whywhywhyt/fpga-sram-demo/engineering/README.md

# 工程快照

展示入口位于包根目录01_download_sram.cmd，使用固定已验证SVF，无TD依赖。
这里保留源码/IP、约束、仿真和最终证据。reports中的原电脑绝对路径与sram_downloaded字段是历史构建/下载记录，不代表接收电脑的状态。
省略可再生中间数据库与仿真work；改源码需从综合重建，不使用旧Resume。
