whywhywhyt/fpga-sram-demo/01_全部功能与按键.md

# 当前全功能与按键

本文件适用于 `sc520_cal_final_2026-11-01`。普通短按小于半秒，松手后执行；不要套用10月31日旧包的长K1开灯操作。

## 图像与处理

摄像头实时采集，DDR缓存，HDMI 1280×720显示。八模式依次是：彩色原图、灰度、二值化、Prewitt边缘、图像增强、颜色形状识别、运动检测、卡通化。启动默认边缘模式，短K2随时回原图。

图像处理含自动白平衡、按键触发白场标定与空间色彩补偿、显示中间调提亮、温和降噪及三档增强。白场校色不是全自动寻找白纸：需先摆好均匀白纸再按键。降噪和提亮不代表噪点、偏色已经完全消除。

颜色识别支持红、黄、绿、蓝；形状支持圆、三角、矩形，含未知分类，正方形归矩形。目标框按颜色显示，框附近显示颜色、形状和中心坐标，最多显示4个目标。建议实体红块移动展示坐标，电脑大色块和实心几何图案静态展示类别。传统颜色分割、连通域和几何特征，没有使用CNN或YOLO。

运动检测显示主要变化区域框及运动量。运动量不是实际物理速度；处理延时也不是摄像头到人眼的完整延迟。卡通化显示颜色分层与边缘描线。

## 按键总表

|操作|功能|
|---|---|
|短K1|原图→灰度→二值→边缘→增强→识别→运动→卡通→原图|
|短K2或单独长K2|回彩色原图，不关闭校色|
|K1+K2同时约2秒，全部松开|采白校色，成功后持续应用；按久不清表|
|单独长K3约2秒，任意图像模式|灯墙开/关；重新开启回流光|
|二值/边缘/识别/卡通，短K3/K4|对应阈值增加/减少；运动模式无此短按调参|
|增强，短K3/K4|增强低/中/高升档/降档|
|原图且灯墙开，短K4|流光→绘画→定格→彩虹涟漪→流光|
|流光/定格/涟漪，短K3|采背景，并返回流光|
|绘画，短K3|落笔/抬笔|
|绘画，长K4约1秒|换笔色并抬笔；之后短K3落笔|
|绘画，K3+K4同时约1秒|清屏并抬笔；之后短K3落笔|

## 校色

采白前固定摄像头和光照，白纸覆盖整个视场，避开手影、彩色边缘、反光和过曝；K1+K2约2秒全部松开，保持约1秒等待ON。采集中/计算中不是完成；FAIL表示此次采样不满足条件，调整白场后重采。失败重采保留已有有效系数，但失败提示仍需处理。

本版不提供CAL OFF，也不假装启动就有校色系数。断电/复位/重新下载后需要重新采白。采白自动算系数，无需逐色手动调RGB，同一光照下切换模式不用重新校色。

视频可说：“左下角ON表示白场校色已启用，用于减轻画面不同位置的偏色，让颜色更自然、均匀。”

## 灯墙四状态

双16×16灯板组成横向32×16。灯墙默认关闭，软件关灯会发送黑帧，外部5V仍存在。先K2回原图，长K3打开，固定机位、清空互动区，短K3采背景。

- 流光：空场全黑；物体进入对应区域有青色轮廓，移动留彩色拖尾，停住当前位置保持，离开渐隐。颜色由程序生成，不要求物体本身是青色。
- 绘画：用红色小卡片/笔帽作定位物，在HDMI画布区域内移动。先看定位十字，再短K3落笔，慢画横线、弧线或波浪；抬笔可移动而不连线。笔色青→蓝→紫→红→橙→绿，与红色定位物的颜色分开。
- 定格：保持画布，适合作品特写。
- 彩虹涟漪：前景互动，红色起点和彩虹色带扩散渐隐；保留已认可的原彩虹方案。

绘画取景区域为摄像画面约x320～959、y200～519，映射32×16；红色目标建议约4～6厘米、哑光、背景无其它红物。分辨率适合粗轮廓与简单符号，不适合精细字迹。遮挡和照明变化也可能被背景比较当作前景，不是专用手分类。

摄像头机位或照明变化后应重采灯墙背景。白纸校色与空场采背景需依次进行，不要拿白纸当灯墙空背景。
