whywhywhyt/fpga-sram-demo/02_全功能拍摄流程.md

# 全功能拍摄流程与按键

拍摄采用SRAM临时下载，不写Flash。本文以八图像模式、双灯板、K3长按开关的完整工程为准。
2026-11-01 16:37:48，`sc520_cal_final_2026-11-01`已下载到SRAM并通过DONE校验，未写Flash。本文按键均针对本次下载版本；仍需现场采白并检查实际画面。

## 开拍前完成

1. 保持开发板、USB、摄像头、HDMI、双灯板与5V电源的现有接线。下载后保持开发板供电，拍摄中不要重置或重新下载。
2. 固定摄像头位置、焦距和房间照明。准备白纸、实体红块、红色笔帽或红色小色卡，以及电脑上的四色/形状页面。
3. SRAM下载通过后等待约10秒，短按K2回彩色原图，检查实时画面、字幕、K1切换。
4. 用均匀照明的白纸覆盖整幅画面，K1+K2同时按约2秒后全部松开，再保持白场1秒，确认校色ON。移开白纸后继续使用同一照明。
5. K2回原图，长K3约2秒开启灯墙；固定摄像头，清空互动区域，短K3采背景，等待约2秒。测试双板左右连续。
6. 流光、绘画、定格、涟漪各试一次。准备拍图像模式时可长K3关闭灯墙；需要灯墙演示再长K3开启，回流光。

采白自动计算系数，无需手调RGB或为每种颜色重复校色。断电/重下载后需重新采白；摄像头位置或场景照明改变后需重新采灯墙背景。

## 建议拍摄顺序

| 顺序 | 展示项目 | 操作 | 拍到的现象 |
|---|---|---|---|
| 1 | 系统整体与实时原图 | 先拍摄像头、开发板、HDMI和双灯板，短K2；移动实体红块 | 实物动作与显示器实时画面对应，中文字幕清楚 |
| 2 | 灰度图像 | 从原图短K1一次 | 同一物体转为灰度，保留明暗层次 |
| 3 | 二值化和阈值 | 再短K1，短K3/K4分别加减阈值 | 黑白区域随阈值变化，参数提示可见 |
| 4 | 边缘检测和阈值 | 再短K1，用包装盒、纸片或手；短K3/K4 | 边缘轮廓及阈值调节的变化 |
| 5 | 图像增强低/中/高 | 再短K1，短K3提高、短K4降低档位 | 同一场景三档对比，强度字幕对应 |
| 6 | 颜色形状识别 | 再短K1，先移动实体红块，再展示电脑上的红黄绿蓝及圆形/三角形/矩形 | 框颜色与目标对应，上方颜色、形状及坐标；移动红块展示坐标连续变化 |
| 7 | 运动检测 | 再短K1，固定相机，单个物体缓慢左右移动后停住 | 主要变化区域框和运动量变化 |
| 8 | 卡通化 | 再短K1，拍色块、脸部或包装盒；短K3/K4可调边缘阈值 | 颜色分层、描边；再短K1回原图比较 |
| 9 | 灯墙开关和流光 | K2原图，长K3打开；清空区域短K3采背景后伸手 | 空场全黑，物体进入点亮、移动留拖尾、停住保留、离开渐隐 |
| 10 | 隔空绘画与换色 | 流光短K4到绘画；红色笔尖被识别后短K3落笔，慢速画横线/波浪；短K3抬笔移动 | 笔迹保留；抬笔移动不连线 |
| 11 | 多色绘画 | 绘画长K4约1秒换色，再短K3落笔画第二条线 | 新旧笔迹颜色不同，旧图不变色 |
| 12 | 定格 | 从绘画短K4一次 | 作品保持，手和笔离开画面后图案不变 |
| 13 | 彩虹涟漪 | 从定格再短K4一次，手伸入、移动、抽离 | 红色起点、彩虹色带和扩散渐隐 |
| 14 | 灯墙关闭 | 长K3约2秒 | 双板熄灭，HDMI实时画面继续工作 |

每个静态效果停留约3～5秒，参数变化时先保持物体和相机不动。形状使用大、实心、背景干净的样本；正方形属于当前矩形类别。正式录制前先把这些样本各试一次。

电脑四色/形状参考页：`test_cards/known_colors_shapes.html`。
实体红块用于移动坐标演示；绘画使用红色小物体作笔尖，笔迹颜色由按键选择。

## 按键速查

| 操作 | 功能 |
|---|---|
| 短K1 | 原图→灰度→二值→边缘→增强→颜色形状→运动→卡通→原图 |
| 短K2 | 回原图 |
| K1+K2约2秒全部松开 | 采白校色；成功后持续使用 |
| 单独长K3约2秒 | 灯墙开/关；重开回流光 |
| 原图且灯墙开启，短K4 | 流光→绘画→定格→彩虹涟漪→流光 |
| 流光/定格/涟漪短K3 | 采背景并回流光 |
| 绘画短K3 | 落笔/抬笔 |
| 绘画长K4约1秒 | 换笔色并抬笔，之后短K3才能继续画 |
| 绘画K3+K4同时约1秒 | 清屏并抬笔，之后短K3才能继续画 |
| 二值/边缘/识别/卡通短K3/K4 | 相应阈值增加/减少 |
| 增强短K3/K4 | 档位提高/降低 |

短按建议少于半秒、松手执行。灯墙短按操作先K2回原图；在其它图像模式下，K3/K4用于该模式参数。
灯墙默认关闭；软件关闭仍保留外部5V供电。拍灯墙时手机适当降低拍摄曝光，更容易拍清轮廓和色带。

## 版本记录

本包当前版本和位流哈希见VERSION.json。队友下载成功后，自己的凭据位于logs/日期时间/receipt.json。
evidence目录是原开发板的成功记录，不等于接收板已下载或视觉验收。
