whywhywhyt/fpga-sram-demo/04_硬件接线与重编译.md

# 硬件接线与后续工程

目标硬件：HX1P35A；器件PH1P35MDG324，速度等级-3；SC520CS摄像头；HDMI显示器；两块WS2812B 16×16灯板横向32×16。

|节点|连接|
|---|---|
|FPGA P5 / J1第15脚|已验证转换模块3.3V侧输入通道|
|该通道对应5V侧输出|第一灯板DIN|
|第一灯板DOUT|第二灯板DIN|
|两块灯板5V|外部5V适配器正极并联分线，各自供电|
|两块灯板GND|外部5V适配器负极|
|FPGA J1第30脚GND、模块中央GND|与灯板GND和适配器负极共地|
|模块电源|沿用已验证3V3/5V接法；不把5V信号接普通FPGA IO|

模块具体通道按原实物已确认的3.3V输入→5V输出方向，不依据缺失照片推测A/B命名。灯板主电源用独立电源线，杜邦线用于信号；不要用FPGA的3V3给灯板供电。改线时开发板和灯板电源都关闭。双板电流依赖亮度，本工程有限亮，不按适配器额定值推断双板不限亮满白也可运行。

## 工程入口

先将 `工程源码_可选.zip` 解压到短路径（例如 `C:\f`），再打开其中的 `engineering/candidates/sc520_cal_final_2026-11-01/candidate/sc520_shapes/td_project/camera_to_dsi_display.al`。展示下载无需解压此源码ZIP。

源文件、IP、引脚和时序约束使用该工程中的相对路径，已核对所有.al文件引用存在。工具版本Anlogic TD 6.2.1 / 6.2.168116；建议把整个交接包放到短英文路径，打开.al后从综合开始构建。仿真使用ModelSim Intel Starter 18.1或兼容环境；sim目录保留全部40套既有检查的脚本、向量和成功日志，原modelsim.ini中安装库路径需适配本机。

工程tools下原构建/时序脚本为工程追溯保留，含原电脑工具目录和短盘符处理。换电脑重新编译时先设置实际TD路径，不要直接运行原program_sram.ps1；展示下载统一使用包根目录01_download_sram.cmd。

省略了可再生的布局/综合数据库、仿真work和波形；完整源码、IP、约束、最终bit、area/timing报告及证据均已保留。修改源码后，旧SVF/bit仅代表此次冻结版本；必须重新编译通过、生成新SRAM SVF并重新校验，不能只改源码后继续用旧成功回执。

当前最终资源Slice 20342/21216，ERAM 90/108，DSP 35/40；Setup +0.004ns，Hold +0.020ns，TNS均0。时序余量较小，不能放松约束冒充闭合。
