whywhywhyt/fpga-sram-demo/05_给接续工程师或AI.md

# 冻结状态与接续边界

唯一展示版本为sc520_cal_final_2026-11-01，bit哈希见VERSION.json。此版从已下载成功的完整字幕工程派生，删除CAL OFF和长K2旁路、超长K1+K2清表。只改按键/校色启用策略/状态字幕，未借此变更校色公式、检测、灯效或亮度算法。

校色采用现有五点二维平滑空间补偿，不把本版宣传为新完成的九分区算法。自动白平衡与人工放置白纸、按键触发自动标定应分开说明。无有效启动系数时显示未校准，不能只改ON文字。无效重采不覆盖旧有效表；系数仅易失保存，没有Flash持久化。

40套回归中18套针对改动重新执行，22套核对依赖源码、向量与日志哈希后继承；并有字幕逐像素验证、最终资源/时序检查。源开发板已经SRAM/DONE成功，接收电脑的下载和实际显示结果需要自己检查。不要把历史source_board_receipt当作本机已成功下载，也不要把DONE当作视觉验收。

其它框稳定性/颜色形状/画质的进一步优化按用户要求暂停，当前不继续增加功能。历史偏暗和白场一致性已有改善反馈，但噪点、残余偏色和形状误识仍不等于彻底解决。不要把未实现功能写成已完成：没有CNN/YOLO、声音输出、可靠人员安全停机、任意手势分类或精细书写。

接收者只需展示时，使用根目录cmd；无需重编译。不自动改驱动，不写Flash，不随意改引脚/时钟或放松时序。原开发端的源码、旧位流和运行状态此次导出均保持。
