whywhywhyt/fpga-sram-demo/engineering/candidates/sc520_cal_final_2026-11-01/reports/caption_rtl_0.png

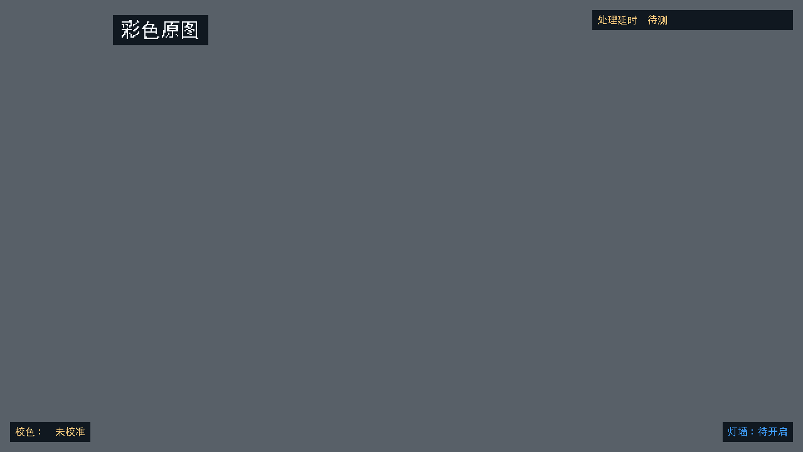
engineering/candidates/sc520_cal_final_2026-11-01/reports/caption_rtl_0.png
