whywhywhyt/fpga-sram-demo/engineering/candidates/sc520_cal_final_2026-11-01/reports/字幕实际RTL预览.png

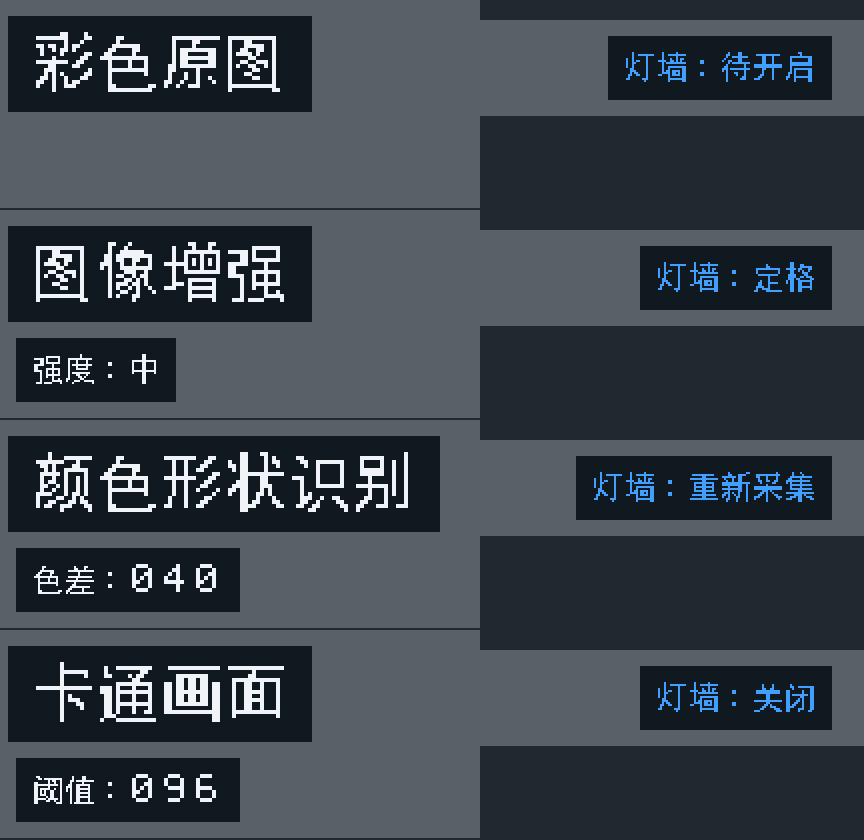
engineering/candidates/sc520_cal_final_2026-11-01/reports/字幕实际RTL预览.png
