whywhywhyt/fpga-sram-demo/test_cards/qa_four_triangles.png

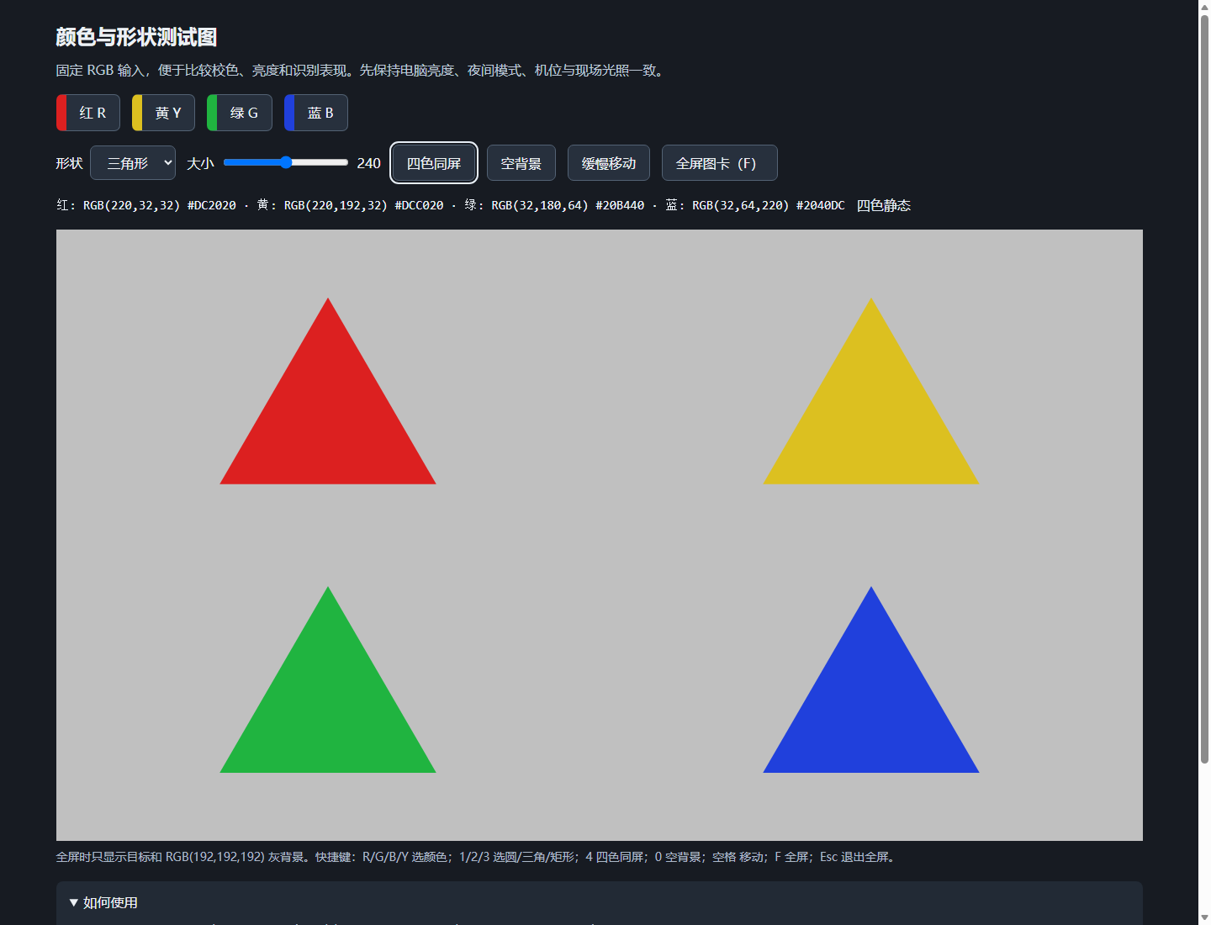
test_cards/qa_four_triangles.png
