whywhywhyt/fpga-sram-demo/engineering/candidates/sc520_cal_final_2026-11-01/candidate/sc520_shapes/user_source/hdl_source/osd_font5x7.v

module osd_title_char(input wire [4:0] pos, output reg [7:0] code);
always @(*) begin case(pos)
5'd0: code = 8'd82;
5'd1: code = 8'd71;
5'd2: code = 8'd66;
5'd3: code = 8'd32;
5'd4: code = 8'd71;
5'd5: code = 8'd82;
5'd6: code = 8'd65;
5'd7: code = 8'd89;
5'd8: code = 8'd32;
5'd9: code = 8'd66;
5'd10: code = 8'd73;
5'd11: code = 8'd78;
5'd12: code = 8'd65;
5'd13: code = 8'd82;
5'd14: code = 8'd89;
5'd15: code = 8'd32;
5'd16: code = 8'd69;
5'd17: code = 8'd68;
5'd18: code = 8'd71;
5'd19: code = 8'd69;
default: code = 8'd32;
endcase end
endmodule
module osd_font5x7(input wire [7:0] code, input wire [2:0] row, output reg [4:0] bits);
reg [34:0] glyph;
always @(*) begin case(code)
8'd75: glyph = 35'b10001100101010011000101001001010001;
8'd70: glyph = 35'b10000100001000011110100001000011111;
8'd85: glyph = 35'b01110100011000110001100011000110001;
8'd77: glyph = 35'b10001100011000110101101011101110001;
8'd79: glyph = 35'b01110100011000110001100011000101110;
8'd72: glyph = 35'b10001100011000111111100011000110001;
8'd76: glyph = 35'b11111100001000010000100001000010000;
8'd51: glyph = 35'b11110000010000101110000010000111110;
8'd52: glyph = 35'b00010000101111110010010100011000010;
8'd53: glyph = 35'b11110000010000111110100001000011111;
8'd54: glyph = 35'b01110100011000111110100001000001110;
8'd57: glyph = 35'b01110000010000101111100011000101110;
8'd46: glyph = 35'b00110001100000000000000000000000000;
8'd40: glyph = {5'b00110,5'b00100,5'b01000,5'b01000,5'b01000,5'b00100,5'b00010};
8'd41: glyph = {5'b01100,5'b00100,5'b00010,5'b00010,5'b00010,5'b00100,5'b01000};
8'd44: glyph = {5'b00000,5'b00110,5'b00110,5'b00010,5'b00100,5'b00000,5'b00000};
8'd45: glyph = 35'b00000000000000011111000000000000000;

8'd65: glyph = 35'b10001100011000111111100011000101110;
8'd66: glyph = 35'b11110100011000111110100011000111110;
8'd67: glyph = 35'b01111100001000010000100001000001111;
8'd78: glyph = 35'b10001100111001110101110011100110001;
8'd83: glyph = 35'b11110000010000101110100001000001111;
8'd89: glyph = 35'b00100001000010000100010101000110001;

8'd80: glyph = 35'b10000100001000011110100011000111110;
8'd82: glyph = 35'b10001100101010011110100011000111110;
8'd69: glyph = 35'b11111100001000011110100001000011111;
8'd87: glyph = 35'b01010101011010110101100011000110001;
8'd73: glyph = 35'b11111001000010000100001000010011111;
8'd84: glyph = 35'b00100001000010000100001000010011111;
8'd68: glyph = 35'b11110100011000110001100011000111110;
8'd71: glyph = 35'b01111100011000110111100001000001111;
8'd49: glyph = 35'b01110001000010000100001000110000100;
8'd50: glyph = 35'b11111010000010000010000011000101110;
8'd56: glyph = 35'b01110100011000101110100011000101110;
8'd48: glyph = 35'b01110100011100110101100111000101110;
8'd88: glyph = 35'b10001100010101000100010101000110001;
8'd55: glyph = 35'b01000010000100000100000100000111111;
8'd32: glyph = 35'b00000000000000000000000000000000000;
default: glyph=0;
endcase
bits = row < 7 ? (glyph >> (row*5)) : 5'd0;
end
endmodule

// Local, fixed 16x16 Chinese glyphs. ASCII retains the existing 5x7 bitmap.
// No external font file, block RAM, multiplier, or added stream latency.
module presentation_font16(input wire [7:0] code,input wire [3:0] row,
 output wire [15:0] bits);
 wire [4:0] latin;
 wire [7:0] latin_code=code==109?8'd77:code==115?8'd83:code;
 osd_font5x7 ascii_font(.code(latin_code),.row(row[3:1]),.bits(latin));
 reg [15:0] chinese;
 always @* begin
  chinese=0;
  case({code,row})
   // 彩: complete SimHei glyph, centered inside 16x16
   12'h800:chinese=16'h0184;
   12'h801:chinese=16'h7f86;
   12'h802:chinese=16'h0088;
   12'h803:chinese=16'h6cb0;
   12'h804:chinese=16'h25a0;
   12'h805:chinese=16'h2106;
   12'h806:chinese=16'h040c;
   12'h807:chinese=16'h7f98;
   12'h808:chinese=16'h0c30;
   12'h809:chinese=16'h1c02;
   12'h80a:chinese=16'h1506;
   12'h80b:chinese=16'h348c;
   12'h80c:chinese=16'h64b0;
   12'h80d:chinese=16'h44e0;
   12'h80e:chinese=16'h0400;
   // 色: complete SimHei glyph, centered inside 16x16
   12'h811:chinese=16'h0600;
   12'h812:chinese=16'h0400;
   12'h813:chinese=16'h0fe0;
   12'h814:chinese=16'h1860;
   12'h815:chinese=16'h3040;
   12'h816:chinese=16'h7ff8;
   12'h817:chinese=16'h1088;
   12'h818:chinese=16'h1088;
   12'h819:chinese=16'h1ff8;
   12'h81a:chinese=16'h1008;
   12'h81b:chinese=16'h1000;
   12'h81c:chinese=16'h1000;
   12'h81d:chinese=16'h1806;
   12'h81e:chinese=16'h1ffc;
   // 原: complete SimHei glyph, centered inside 16x16
   12'h821:chinese=16'h1ffe;
   12'h822:chinese=16'h10c0;
   12'h823:chinese=16'h1080;
   12'h824:chinese=16'h17fc;
   12'h825:chinese=16'h160c;
   12'h826:chinese=16'h17fc;
   12'h827:chinese=16'h160c;
   12'h828:chinese=16'h37fc;
   12'h829:chinese=16'h3040;
   12'h82a:chinese=16'h2240;
   12'h82b:chinese=16'h2248;
   12'h82c:chinese=16'h6444;
   12'h82d:chinese=16'h49c0;
   // 图: complete SimHei glyph, centered inside 16x16
   12'h831:chinese=16'h7ff8;
   12'h832:chinese=16'h4608;
   12'h833:chinese=16'h47c8;
   12'h834:chinese=16'h4cc8;
   12'h835:chinese=16'h5e88;
   12'h836:chinese=16'h4308;
   12'h837:chinese=16'h4ce8;
   12'h838:chinese=16'h5328;
   12'h839:chinese=16'h4188;
   12'h83a:chinese=16'h4608;
   12'h83b:chinese=16'h4188;
   12'h83c:chinese=16'h4008;
   12'h83d:chinese=16'h7ff8;
   12'h83e:chinese=16'h400c;
   // 灰: complete SimHei glyph, centered inside 16x16
   12'h841:chinese=16'h0200;
   12'h842:chinese=16'h0200;
   12'h843:chinese=16'h3ffe;
   12'h844:chinese=16'h0400;
   12'h845:chinese=16'h0440;
   12'h846:chinese=16'h0c40;
   12'h847:chinese=16'h0a4c;
   12'h848:chinese=16'h1a48;
   12'h849:chinese=16'h1648;
   12'h84a:chinese=16'h30e0;
   12'h84b:chinese=16'h60a0;
   12'h84c:chinese=16'h4190;
   12'h84d:chinese=16'h030c;
   12'h84e:chinese=16'h1c06;
   // 度: complete SimHei glyph, centered inside 16x16
   12'h850:chinese=16'h0080;
   12'h851:chinese=16'h0080;
   12'h852:chinese=16'h3ffc;
   12'h853:chinese=16'h2210;
   12'h854:chinese=16'h2210;
   12'h855:chinese=16'h2ffc;
   12'h856:chinese=16'h2210;
   12'h857:chinese=16'h23f0;
   12'h858:chinese=16'h2000;
   12'h859:chinese=16'h2ff8;
   12'h85a:chinese=16'h2310;
   12'h85b:chinese=16'h21a0;
   12'h85c:chinese=16'h60c0;
   12'h85d:chinese=16'h473e;
   12'h85e:chinese=16'h0802;
   // 像: complete SimHei glyph, centered inside 16x16
   12'h860:chinese=16'h1880;
   12'h861:chinese=16'h1100;
   12'h862:chinese=16'h13f0;
   12'h863:chinese=16'h37fc;
   12'h864:chinese=16'h3664;
   12'h865:chinese=16'h7244;
   12'h866:chinese=16'h53fc;
   12'h867:chinese=16'h11c8;
   12'h868:chinese=16'h1658;
   12'h869:chinese=16'h11a8;
   12'h86a:chinese=16'h1768;
   12'h86b:chinese=16'h14a4;
   12'h86c:chinese=16'h1322;
   12'h86d:chinese=16'h1460;
   12'h86e:chinese=16'h0040;
   // 二: complete SimHei glyph, centered inside 16x16
   12'h873:chinese=16'h3ff8;
   12'h87b:chinese=16'h7ffe;
   12'h87c:chinese=16'h7ffe;
   // 值: complete SimHei glyph, centered inside 16x16
   12'h881:chinese=16'h0860;
   12'h882:chinese=16'h0860;
   12'h883:chinese=16'h1bfe;
   12'h884:chinese=16'h1040;
   12'h885:chinese=16'h33f8;
   12'h886:chinese=16'h7308;
   12'h887:chinese=16'h53f8;
   12'h888:chinese=16'h5308;
   12'h889:chinese=16'h13f8;
   12'h88a:chinese=16'h1308;
   12'h88b:chinese=16'h13f8;
   12'h88c:chinese=16'h1308;
   12'h88d:chinese=16'h1308;
   12'h88e:chinese=16'h17fe;
   // 边: complete SimHei glyph, centered inside 16x16
   12'h891:chinese=16'h2040;
   12'h892:chinese=16'h2040;
   12'h893:chinese=16'h3040;
   12'h894:chinese=16'h13fc;
   12'h895:chinese=16'h0044;
   12'h896:chinese=16'h00c4;
   12'h897:chinese=16'h7084;
   12'h898:chinese=16'h1084;
   12'h899:chinese=16'h1184;
   12'h89a:chinese=16'h1104;
   12'h89b:chinese=16'h133c;
   12'h89c:chinese=16'h1218;
   12'h89d:chinese=16'h2c00;
   12'h89e:chinese=16'h43fe;
   // 缘: complete SimHei glyph, centered inside 16x16
   12'h8a0:chinese=16'h10c0;
   12'h8a1:chinese=16'h30f8;
   12'h8a2:chinese=16'h2088;
   12'h8a3:chinese=16'h2d38;
   12'h8a4:chinese=16'h49d0;
   12'h8a5:chinese=16'h77fe;
   12'h8a6:chinese=16'h1440;
   12'h8a7:chinese=16'h21cc;
   12'h8a8:chinese=16'h6378;
   12'h8a9:chinese=16'h78b8;
   12'h8aa:chinese=16'h0734;
   12'h8ab:chinese=16'h02d4;
   12'h8ac:chinese=16'h7992;
   12'h8ad:chinese=16'h0670;
   12'h8ae:chinese=16'h0040;
   // 检: complete SimHei glyph, centered inside 16x16
   12'h8b0:chinese=16'h1060;
   12'h8b1:chinese=16'h1060;
   12'h8b2:chinese=16'h10f0;
   12'h8b3:chinese=16'h7c90;
   12'h8b4:chinese=16'h110c;
   12'h8b5:chinese=16'h13f6;
   12'h8b6:chinese=16'h3200;
   12'h8b7:chinese=16'h3d44;
   12'h8b8:chinese=16'h776c;
   12'h8b9:chinese=16'h5128;
   12'h8ba:chinese=16'h51a8;
   12'h8bb:chinese=16'h1010;
   12'h8bc:chinese=16'h1410;
   12'h8bd:chinese=16'h17fe;
   12'h8be:chinese=16'h1000;
   // 测: complete SimHei glyph, centered inside 16x16
   12'h8c1:chinese=16'h0006;
   12'h8c2:chinese=16'h77c6;
   12'h8c3:chinese=16'h1456;
   12'h8c4:chinese=16'h0456;
   12'h8c5:chinese=16'h4556;
   12'h8c6:chinese=16'h6556;
   12'h8c7:chinese=16'h2556;
   12'h8c8:chinese=16'h0556;
   12'h8c9:chinese=16'h1556;
   12'h8ca:chinese=16'h1556;
   12'h8cb:chinese=16'h2396;
   12'h8cc:chinese=16'h2286;
   12'h8cd:chinese=16'h4646;
   12'h8ce:chinese=16'h4c4e;
   // 增: complete SimHei glyph, centered inside 16x16
   12'h8d0:chinese=16'h018c;
   12'h8d1:chinese=16'h1088;
   12'h8d2:chinese=16'h13fe;
   12'h8d3:chinese=16'h1222;
   12'h8d4:chinese=16'h12aa;
   12'h8d5:chinese=16'h7eaa;
   12'h8d6:chinese=16'h1222;
   12'h8d7:chinese=16'h13fe;
   12'h8d8:chinese=16'h1000;
   12'h8d9:chinese=16'h11fc;
   12'h8da:chinese=16'h1d04;
   12'h8db:chinese=16'h71fc;
   12'h8dc:chinese=16'h0104;
   12'h8dd:chinese=16'h01fc;
   12'h8de:chinese=16'h0104;
   // 强: complete SimHei glyph, centered inside 16x16
   12'h8e1:chinese=16'h01fc;
   12'h8e2:chinese=16'h7d04;
   12'h8e3:chinese=16'h0d04;
   12'h8e4:chinese=16'h0dfc;
   12'h8e5:chinese=16'h7c20;
   12'h8e6:chinese=16'h6020;
   12'h8e7:chinese=16'h61fc;
   12'h8e8:chinese=16'h7924;
   12'h8e9:chinese=16'h0924;
   12'h8ea:chinese=16'h09fc;
   12'h8eb:chinese=16'h0920;
   12'h8ec:chinese=16'h0824;
   12'h8ed:chinese=16'h083e;
   12'h8ee:chinese=16'h3bc2;
   // 颜: complete SimHei glyph, centered inside 16x16
   12'h8f0:chinese=16'h0800;
   12'h8f1:chinese=16'h08fe;
   12'h8f2:chinese=16'h7f10;
   12'h8f3:chinese=16'h3430;
   12'h8f4:chinese=16'h14fc;
   12'h8f5:chinese=16'h3e84;
   12'h8f6:chinese=16'h2494;
   12'h8f7:chinese=16'h2c94;
   12'h8f8:chinese=16'h3294;
   12'h8f9:chinese=16'h2494;
   12'h8fa:chinese=16'h78b4;
   12'h8fb:chinese=16'h4328;
   12'h8fc:chinese=16'h4c6c;
   12'h8fd:chinese=16'h59c6;
   12'h8fe:chinese=16'h0102;
   // 形: complete SimHei glyph, centered inside 16x16
   12'h901:chinese=16'h7f8c;
   12'h902:chinese=16'h1218;
   12'h903:chinese=16'h1230;
   12'h904:chinese=16'h1260;
   12'h905:chinese=16'h1206;
   12'h906:chinese=16'h7f8c;
   12'h907:chinese=16'h1218;
   12'h908:chinese=16'h1230;
   12'h909:chinese=16'h1242;
   12'h90a:chinese=16'h1204;
   12'h90b:chinese=16'h2218;
   12'h90c:chinese=16'h2230;
   12'h90d:chinese=16'h6260;
   // 状: complete SimHei glyph, centered inside 16x16
   12'h910:chinese=16'h0c60;
   12'h911:chinese=16'h0c28;
   12'h912:chinese=16'h4c2c;
   12'h913:chinese=16'h6c24;
   12'h914:chinese=16'h2c20;
   12'h915:chinese=16'h0ffe;
   12'h916:chinese=16'h0c60;
   12'h917:chinese=16'h1c60;
   12'h918:chinese=16'h3c70;
   12'h919:chinese=16'h6c50;
   12'h91a:chinese=16'h4cd0;
   12'h91b:chinese=16'h0c88;
   12'h91c:chinese=16'h0d8c;
   12'h91d:chinese=16'h0f06;
   12'h91e:chinese=16'h0c00;
   // 识: complete SimHei glyph, centered inside 16x16
   12'h921:chinese=16'h3000;
   12'h922:chinese=16'h19fc;
   12'h923:chinese=16'h0904;
   12'h924:chinese=16'h0104;
   12'h925:chinese=16'h0104;
   12'h926:chinese=16'h7104;
   12'h927:chinese=16'h1104;
   12'h928:chinese=16'h11fc;
   12'h929:chinese=16'h1000;
   12'h92a:chinese=16'h1400;
   12'h92b:chinese=16'h1c98;
   12'h92c:chinese=16'h190c;
   12'h92d:chinese=16'h3306;
   12'h92e:chinese=16'h0602;
   // 别: complete SimHei glyph, centered inside 16x16
   12'h930:chinese=16'h0004;
   12'h931:chinese=16'h3f04;
   12'h932:chinese=16'h2124;
   12'h933:chinese=16'h2124;
   12'h934:chinese=16'h3f24;
   12'h935:chinese=16'h3f24;
   12'h936:chinese=16'h0824;
   12'h937:chinese=16'h0824;
   12'h938:chinese=16'h7fa4;
   12'h939:chinese=16'h08a4;
   12'h93a:chinese=16'h08a4;
   12'h93b:chinese=16'h1884;
   12'h93c:chinese=16'h3084;
   12'h93d:chinese=16'h639c;
   12'h93e:chinese=16'h4000;
   // 阈: complete SimHei glyph, centered inside 16x16
   12'h941:chinese=16'h3000;
   12'h942:chinese=16'h1bfe;
   12'h943:chinese=16'h00b2;
   12'h944:chinese=16'h6092;
   12'h945:chinese=16'h7ffa;
   12'h946:chinese=16'h6082;
   12'h947:chinese=16'h6f92;
   12'h948:chinese=16'h6a62;
   12'h949:chinese=16'h6a62;
   12'h94a:chinese=16'h6e62;
   12'h94b:chinese=16'h6162;
   12'h94c:chinese=16'h7efa;
   12'h94d:chinese=16'h6192;
   12'h94e:chinese=16'h600e;
   // 低: complete SimHei glyph, centered inside 16x16
   12'h950:chinese=16'h0800;
   12'h951:chinese=16'h18fc;
   12'h952:chinese=16'h13a0;
   12'h953:chinese=16'h1220;
   12'h954:chinese=16'h3220;
   12'h955:chinese=16'h3220;
   12'h956:chinese=16'h53fe;
   12'h957:chinese=16'h5220;
   12'h958:chinese=16'h1220;
   12'h959:chinese=16'h1230;
   12'h95a:chinese=16'h1290;
   12'h95b:chinese=16'h1392;
   12'h95c:chinese=16'h138a;
   12'h95d:chinese=16'h124e;
   12'h95e:chinese=16'h1000;
   // 中: complete SimHei glyph, centered inside 16x16
   12'h960:chinese=16'h0180;
   12'h961:chinese=16'h0180;
   12'h962:chinese=16'h0180;
   12'h963:chinese=16'h3ffc;
   12'h964:chinese=16'h2184;
   12'h965:chinese=16'h2184;
   12'h966:chinese=16'h2184;
   12'h967:chinese=16'h2184;
   12'h968:chinese=16'h3ffc;
   12'h969:chinese=16'h2184;
   12'h96a:chinese=16'h0180;
   12'h96b:chinese=16'h0180;
   12'h96c:chinese=16'h0180;
   12'h96d:chinese=16'h0180;
   12'h96e:chinese=16'h0180;
   // 高: complete SimHei glyph, centered inside 16x16
   12'h970:chinese=16'h0100;
   12'h971:chinese=16'h0180;
   12'h972:chinese=16'h7ffe;
   12'h973:chinese=16'h1ff0;
   12'h974:chinese=16'h0810;
   12'h975:chinese=16'h0810;
   12'h976:chinese=16'h1ff0;
   12'h977:chinese=16'h7ffe;
   12'h978:chinese=16'h2006;
   12'h979:chinese=16'h27e6;
   12'h97a:chinese=16'h2426;
   12'h97b:chinese=16'h2426;
   12'h97c:chinese=16'h27e6;
   12'h97d:chinese=16'h200e;
   12'h97e:chinese=16'h0008;
   // 差: complete SimHei glyph, centered inside 16x16
   12'h981:chinese=16'h0430;
   12'h982:chinese=16'h0620;
   12'h983:chinese=16'h3ffe;
   12'h984:chinese=16'h0100;
   12'h985:chinese=16'h0100;
   12'h986:chinese=16'h3ffc;
   12'h987:chinese=16'h0200;
   12'h988:chinese=16'h7ffe;
   12'h989:chinese=16'h0400;
   12'h98a:chinese=16'h0c00;
   12'h98b:chinese=16'h1ff8;
   12'h98c:chinese=16'h3040;
   12'h98d:chinese=16'h6040;
   12'h98e:chinese=16'h5ffe;
   // 校: complete SimHei glyph, centered inside 16x16
   12'h990:chinese=16'h1020;
   12'h991:chinese=16'h1030;
   12'h992:chinese=16'h13fe;
   12'h993:chinese=16'h7c00;
   12'h994:chinese=16'h1088;
   12'h995:chinese=16'h10cc;
   12'h996:chinese=16'h3106;
   12'h997:chinese=16'h3d08;
   12'h998:chinese=16'h7488;
   12'h999:chinese=16'h50d8;
   12'h99a:chinese=16'h5070;
   12'h99b:chinese=16'h1020;
   12'h99c:chinese=16'h10d8;
   12'h99d:chinese=16'h178e;
   12'h99e:chinese=16'h0202;
   // 未: complete SimHei glyph, centered inside 16x16
   12'h9a1:chinese=16'h0100;
   12'h9a2:chinese=16'h0100;
   12'h9a3:chinese=16'h0100;
   12'h9a4:chinese=16'h3ff8;
   12'h9a5:chinese=16'h0100;
   12'h9a6:chinese=16'h0100;
   12'h9a7:chinese=16'h7ffe;
   12'h9a8:chinese=16'h0380;
   12'h9a9:chinese=16'h0740;
   12'h9aa:chinese=16'h0d60;
   12'h9ab:chinese=16'h1930;
   12'h9ac:chinese=16'h311c;
   12'h9ad:chinese=16'h6106;
   12'h9ae:chinese=16'h0100;
   // 准: complete SimHei glyph, centered inside 16x16
   12'h9b0:chinese=16'h0120;
   12'h9b1:chinese=16'h4130;
   12'h9b2:chinese=16'h6300;
   12'h9b3:chinese=16'h33fe;
   12'h9b4:chinese=16'h1620;
   12'h9b5:chinese=16'h0620;
   12'h9b6:chinese=16'h0bfc;
   12'h9b7:chinese=16'h0220;
   12'h9b8:chinese=16'h1220;
   12'h9b9:chinese=16'h33fc;
   12'h9ba:chinese=16'h2220;
   12'h9bb:chinese=16'h6220;
   12'h9bc:chinese=16'h43fe;
   12'h9bd:chinese=16'h0200;
   12'h9be:chinese=16'h0200;
   // 采: complete SimHei glyph, centered inside 16x16
   12'h9c0:chinese=16'h0008;
   12'h9c1:chinese=16'h3ffc;
   12'h9c2:chinese=16'h3108;
   12'h9c3:chinese=16'h1108;
   12'h9c4:chinese=16'h1998;
   12'h9c5:chinese=16'h0830;
   12'h9c6:chinese=16'h0100;
   12'h9c7:chinese=16'h7ffe;
   12'h9c8:chinese=16'h7ffe;
   12'h9c9:chinese=16'h0740;
   12'h9ca:chinese=16'h0d20;
   12'h9cb:chinese=16'h1918;
   12'h9cc:chinese=16'h710e;
   12'h9cd:chinese=16'h4104;
   12'h9ce:chinese=16'h0100;
   // 集: complete SimHei glyph, centered inside 16x16
   12'h9d0:chinese=16'h0880;
   12'h9d1:chinese=16'h0840;
   12'h9d2:chinese=16'h1ffc;
   12'h9d3:chinese=16'h3080;
   12'h9d4:chinese=16'h7ff8;
   12'h9d5:chinese=16'h5080;
   12'h9d6:chinese=16'h1ffc;
   12'h9d7:chinese=16'h1080;
   12'h9d8:chinese=16'h1ffc;
   12'h9d9:chinese=16'h0180;
   12'h9da:chinese=16'h7ffe;
   12'h9db:chinese=16'h07a0;
   12'h9dc:chinese=16'h1d9c;
   12'h9dd:chinese=16'h7186;
   12'h9de:chinese=16'h0180;
   // 计: complete SimHei glyph, centered inside 16x16
   12'h9e1:chinese=16'h0020;
   12'h9e2:chinese=16'h3020;
   12'h9e3:chinese=16'h1820;
   12'h9e4:chinese=16'h0820;
   12'h9e5:chinese=16'h0020;
   12'h9e6:chinese=16'h77fe;
   12'h9e7:chinese=16'h1020;
   12'h9e8:chinese=16'h1020;
   12'h9e9:chinese=16'h1020;
   12'h9ea:chinese=16'h1020;
   12'h9eb:chinese=16'h1620;
   12'h9ec:chinese=16'h1c20;
   12'h9ed:chinese=16'h1820;
   12'h9ee:chinese=16'h1020;
   // 算: complete SimHei glyph, centered inside 16x16
   12'h9f0:chinese=16'h1060;
   12'h9f1:chinese=16'h3f7e;
   12'h9f2:chinese=16'h6cd8;
   12'h9f4:chinese=16'h1ff8;
   12'h9f5:chinese=16'h1ff8;
   12'h9f6:chinese=16'h1008;
   12'h9f7:chinese=16'h1ff8;
   12'h9f8:chinese=16'h1008;
   12'h9f9:chinese=16'h1ff8;
   12'h9fa:chinese=16'h0220;
   12'h9fb:chinese=16'h7ffe;
   12'h9fc:chinese=16'h0420;
   12'h9fd:chinese=16'h3820;
   12'h9fe:chinese=16'h0020;
   // 开: complete SimHei glyph, centered inside 16x16
   12'ha01:chinese=16'h3ffc;
   12'ha02:chinese=16'h0620;
   12'ha03:chinese=16'h0620;
   12'ha04:chinese=16'h0620;
   12'ha05:chinese=16'h0620;
   12'ha06:chinese=16'h7ffe;
   12'ha07:chinese=16'h7ffe;
   12'ha08:chinese=16'h0620;
   12'ha09:chinese=16'h0420;
   12'ha0a:chinese=16'h0420;
   12'ha0b:chinese=16'h0c20;
   12'ha0c:chinese=16'h1820;
   12'ha0d:chinese=16'h7020;
   // 启: complete SimHei glyph, centered inside 16x16
   12'ha10:chinese=16'h0180;
   12'ha11:chinese=16'h0080;
   12'ha12:chinese=16'h1ffc;
   12'ha13:chinese=16'h100c;
   12'ha14:chinese=16'h100c;
   12'ha15:chinese=16'h1ffc;
   12'ha16:chinese=16'h1ffc;
   12'ha17:chinese=16'h1000;
   12'ha18:chinese=16'h17fc;
   12'ha19:chinese=16'h140c;
   12'ha1a:chinese=16'h340c;
   12'ha1b:chinese=16'h240c;
   12'ha1c:chinese=16'h67fc;
   12'ha1d:chinese=16'h440c;
   12'ha1e:chinese=16'h040c;
   // 关: complete SimHei glyph, centered inside 16x16
   12'ha21:chinese=16'h0420;
   12'ha22:chinese=16'h0420;
   12'ha23:chinese=16'h0660;
   12'ha24:chinese=16'h3ffc;
   12'ha25:chinese=16'h3ffc;
   12'ha26:chinese=16'h0180;
   12'ha27:chinese=16'h0180;
   12'ha28:chinese=16'h0180;
   12'ha29:chinese=16'h7ffe;
   12'ha2a:chinese=16'h0180;
   12'ha2b:chinese=16'h0340;
   12'ha2c:chinese=16'h0670;
   12'ha2d:chinese=16'h0c1c;
   12'ha2e:chinese=16'h700e;
   // 闭: complete SimHei glyph, centered inside 16x16
   12'ha31:chinese=16'h1000;
   12'ha32:chinese=16'h19fe;
   12'ha33:chinese=16'h0806;
   12'ha34:chinese=16'h6046;
   12'ha35:chinese=16'h6046;
   12'ha36:chinese=16'h6ff6;
   12'ha37:chinese=16'h60c6;
   12'ha38:chinese=16'h6146;
   12'ha39:chinese=16'h6346;
   12'ha3a:chinese=16'h6646;
   12'ha3b:chinese=16'h6c46;
   12'ha3c:chinese=16'h7846;
   12'ha3d:chinese=16'h61c6;
   12'ha3e:chinese=16'h610c;
   // 失: complete SimHei glyph, centered inside 16x16
   12'ha41:chinese=16'h0180;
   12'ha42:chinese=16'h0180;
   12'ha43:chinese=16'h1980;
   12'ha44:chinese=16'h1180;
   12'ha45:chinese=16'h1ffc;
   12'ha46:chinese=16'h2180;
   12'ha47:chinese=16'h2180;
   12'ha48:chinese=16'h7ffe;
   12'ha49:chinese=16'h7ffe;
   12'ha4a:chinese=16'h0180;
   12'ha4b:chinese=16'h0240;
   12'ha4c:chinese=16'h0630;
   12'ha4d:chinese=16'h1c1c;
   12'ha4e:chinese=16'h7006;
   // 败: complete SimHei glyph, centered inside 16x16
   12'ha50:chinese=16'h0030;
   12'ha51:chinese=16'h3f20;
   12'ha52:chinese=16'h2120;
   12'ha53:chinese=16'h217e;
   12'ha54:chinese=16'h2944;
   12'ha55:chinese=16'h2944;
   12'ha56:chinese=16'h29cc;
   12'ha57:chinese=16'h2948;
   12'ha58:chinese=16'h2928;
   12'ha59:chinese=16'h2928;
   12'ha5a:chinese=16'h0c38;
   12'ha5b:chinese=16'h1610;
   12'ha5c:chinese=16'h2368;
   12'ha5d:chinese=16'h40c6;
   12'ha5e:chinese=16'h0002;
   // 运: complete SimHei glyph, centered inside 16x16
   12'ha61:chinese=16'h33fc;
   12'ha62:chinese=16'h1000;
   12'ha65:chinese=16'h7ffe;
   12'ha66:chinese=16'h7880;
   12'ha67:chinese=16'h1890;
   12'ha68:chinese=16'h1908;
   12'ha69:chinese=16'h191c;
   12'ha6a:chinese=16'h1be4;
   12'ha6b:chinese=16'h1800;
   12'ha6c:chinese=16'h3c00;
   12'ha6d:chinese=16'h43fe;
   // 动: complete SimHei glyph, centered inside 16x16
   12'ha71:chinese=16'h0030;
   12'ha72:chinese=16'h0030;
   12'ha73:chinese=16'h3e30;
   12'ha74:chinese=16'h0030;
   12'ha75:chinese=16'h00fe;
   12'ha76:chinese=16'h7f32;
   12'ha77:chinese=16'h7f22;
   12'ha78:chinese=16'h1022;
   12'ha79:chinese=16'h1622;
   12'ha7a:chinese=16'h2222;
   12'ha7b:chinese=16'h2362;
   12'ha7c:chinese=16'h7d46;
   12'ha7d:chinese=16'h00c6;
   12'ha7e:chinese=16'h019c;
   // 量: complete SimHei glyph, centered inside 16x16
   12'ha81:chinese=16'h1ff8;
   12'ha82:chinese=16'h1ff8;
   12'ha83:chinese=16'h1008;
   12'ha84:chinese=16'h1ff8;
   12'ha85:chinese=16'h7ffe;
   12'ha87:chinese=16'h1ff8;
   12'ha88:chinese=16'h1ff8;
   12'ha89:chinese=16'h1188;
   12'ha8a:chinese=16'h1ff8;
   12'ha8b:chinese=16'h3ff8;
   12'ha8c:chinese=16'h0180;
   12'ha8d:chinese=16'h7ffe;
   // 处: complete SimHei glyph, centered inside 16x16
   12'ha90:chinese=16'h0820;
   12'ha91:chinese=16'h0820;
   12'ha92:chinese=16'h1820;
   12'ha93:chinese=16'h1f20;
   12'ha94:chinese=16'h1128;
   12'ha95:chinese=16'h312c;
   12'ha96:chinese=16'h3126;
   12'ha97:chinese=16'h5b22;
   12'ha98:chinese=16'h0a20;
   12'ha99:chinese=16'h0e20;
   12'ha9a:chinese=16'h0620;
   12'ha9b:chinese=16'h0f20;
   12'ha9c:chinese=16'h19c0;
   12'ha9d:chinese=16'h607e;
   12'ha9e:chinese=16'h4000;
   // 理: complete SimHei glyph, centered inside 16x16
   12'haa1:chinese=16'h01fe;
   12'haa2:chinese=16'h7d26;
   12'haa3:chinese=16'h1126;
   12'haa4:chinese=16'h11fe;
   12'haa5:chinese=16'h1126;
   12'haa6:chinese=16'h7d26;
   12'haa7:chinese=16'h11fe;
   12'haa8:chinese=16'h1020;
   12'haa9:chinese=16'h1020;
   12'haaa:chinese=16'h13fe;
   12'haab:chinese=16'h1c20;
   12'haac:chinese=16'h6020;
   12'haad:chinese=16'h03fe;
   // 延: complete SimHei glyph, centered inside 16x16
   12'hab1:chinese=16'h0008;
   12'hab2:chinese=16'h79f8;
   12'hab3:chinese=16'h1920;
   12'hab4:chinese=16'h1020;
   12'hab5:chinese=16'h1120;
   12'hab6:chinese=16'h213c;
   12'hab7:chinese=16'h3920;
   12'hab8:chinese=16'h0920;
   12'hab9:chinese=16'h4920;
   12'haba:chinese=16'h7920;
   12'habb:chinese=16'h31fc;
   12'habc:chinese=16'h1800;
   12'habd:chinese=16'h2e00;
   12'habe:chinese=16'h43fe;
   // 时: complete SimHei glyph, centered inside 16x16
   12'hac1:chinese=16'h0008;
   12'hac2:chinese=16'h0008;
   12'hac3:chinese=16'h7c08;
   12'hac4:chinese=16'h65fe;
   12'hac5:chinese=16'h65fe;
   12'hac6:chinese=16'h6408;
   12'hac7:chinese=16'h7c88;
   12'hac8:chinese=16'h64c8;
   12'hac9:chinese=16'h6448;
   12'haca:chinese=16'h6408;
   12'hacb:chinese=16'h7c08;
   12'hacc:chinese=16'h6408;
   12'hacd:chinese=16'h6008;
   12'hace:chinese=16'h0038;
   // 待: complete SimHei glyph, centered inside 16x16
   12'had0:chinese=16'h0860;
   12'had1:chinese=16'h1860;
   12'had2:chinese=16'h13fc;
   12'had3:chinese=16'h2060;
   12'had4:chinese=16'h4c60;
   12'had5:chinese=16'h0bfe;
   12'had6:chinese=16'h1008;
   12'had7:chinese=16'h3008;
   12'had8:chinese=16'h77fe;
   12'had9:chinese=16'h5008;
   12'hada:chinese=16'h1188;
   12'hadb:chinese=16'h1088;
   12'hadc:chinese=16'h1018;
   12'hadd:chinese=16'h1038;
   12'hade:chinese=16'h1000;
   // 灯: complete SimHei glyph, centered inside 16x16
   12'hae0:chinese=16'h0800;
   12'hae1:chinese=16'h09fe;
   12'hae2:chinese=16'h0810;
   12'hae3:chinese=16'h4810;
   12'hae4:chinese=16'h4b10;
   12'hae5:chinese=16'h4c10;
   12'hae6:chinese=16'h4810;
   12'hae7:chinese=16'h4810;
   12'hae8:chinese=16'h1810;
   12'hae9:chinese=16'h1c10;
   12'haea:chinese=16'h1610;
   12'haeb:chinese=16'h3310;
   12'haec:chinese=16'h2010;
   12'haed:chinese=16'h6070;
   12'haee:chinese=16'h0020;
   // 墙: complete SimHei glyph, centered inside 16x16
   12'haf0:chinese=16'h1020;
   12'haf1:chinese=16'h13fe;
   12'haf2:chinese=16'h1020;
   12'haf3:chinese=16'h112c;
   12'haf4:chinese=16'h79a8;
   12'haf5:chinese=16'h17fe;
   12'haf6:chinese=16'h1000;
   12'haf7:chinese=16'h13fe;
   12'haf8:chinese=16'h1206;
   12'haf9:chinese=16'h16f6;
   12'hafa:chinese=16'h1ed6;
   12'hafb:chinese=16'h62f6;
   12'hafc:chinese=16'h0206;
   12'hafd:chinese=16'h03fe;
   12'hafe:chinese=16'h0206;
   // 流: complete SimHei glyph, centered inside 16x16
   12'hb00:chinese=16'h00c0;
   12'hb01:chinese=16'h3040;
   12'hb02:chinese=16'h1ffe;
   12'hb03:chinese=16'h0080;
   12'hb04:chinese=16'h4110;
   12'hb05:chinese=16'h6308;
   12'hb06:chinese=16'h37fc;
   12'hb07:chinese=16'h0004;
   12'hb08:chinese=16'h1358;
   12'hb09:chinese=16'h1358;
   12'hb0a:chinese=16'h1358;
   12'hb0b:chinese=16'h2258;
   12'hb0c:chinese=16'h625a;
   12'hb0d:chinese=16'h445e;
   12'hb0e:chinese=16'h0800;
   // 光: complete SimHei glyph, centered inside 16x16
   12'hb11:chinese=16'h0180;
   12'hb12:chinese=16'h0180;
   12'hb13:chinese=16'h118c;
   12'hb14:chinese=16'h1998;
   12'hb15:chinese=16'h0db0;
   12'hb16:chinese=16'h0180;
   12'hb17:chinese=16'h7ffe;
   12'hb18:chinese=16'h0240;
   12'hb19:chinese=16'h0240;
   12'hb1a:chinese=16'h0640;
   12'hb1b:chinese=16'h0440;
   12'hb1c:chinese=16'h0c42;
   12'hb1d:chinese=16'h1846;
   12'hb1e:chinese=16'h707c;
   // 绘: complete SimHei glyph, centered inside 16x16
   12'hb21:chinese=16'h1020;
   12'hb22:chinese=16'h1060;
   12'hb23:chinese=16'h1050;
   12'hb24:chinese=16'h24d8;
   12'hb25:chinese=16'h658c;
   12'hb26:chinese=16'h79fe;
   12'hb27:chinese=16'h0a02;
   12'hb28:chinese=16'h1000;
   12'hb29:chinese=16'h31fe;
   12'hb2a:chinese=16'h7c60;
   12'hb2b:chinese=16'h0048;
   12'hb2c:chinese=16'h0488;
   12'hb2d:chinese=16'h798c;
   12'hb2e:chinese=16'h01f4;
   // 画: complete SimHei glyph, centered inside 16x16
   12'hb31:chinese=16'h3ffe;
   12'hb33:chinese=16'h0ff0;
   12'hb34:chinese=16'h0db0;
   12'hb35:chinese=16'h6db6;
   12'hb36:chinese=16'h6db6;
   12'hb37:chinese=16'h6ff6;
   12'hb38:chinese=16'h6db6;
   12'hb39:chinese=16'h6db6;
   12'hb3a:chinese=16'h6ff6;
   12'hb3b:chinese=16'h6006;
   12'hb3c:chinese=16'h7ffe;
   12'hb3d:chinese=16'h0006;
   12'hb3e:chinese=16'h0006;
   // 定: complete SimHei glyph, centered inside 16x16
   12'hb41:chinese=16'h0100;
   12'hb42:chinese=16'h0180;
   12'hb43:chinese=16'h3ffc;
   12'hb44:chinese=16'h2004;
   12'hb45:chinese=16'h2004;
   12'hb46:chinese=16'h1ff8;
   12'hb47:chinese=16'h0080;
   12'hb48:chinese=16'h0080;
   12'hb49:chinese=16'h0880;
   12'hb4a:chinese=16'h18f8;
   12'hb4b:chinese=16'h1880;
   12'hb4c:chinese=16'h3c80;
   12'hb4d:chinese=16'h2780;
   12'hb4e:chinese=16'h61fe;
   // 格: complete SimHei glyph, centered inside 16x16
   12'hb50:chinese=16'h1800;
   12'hb51:chinese=16'h18c0;
   12'hb52:chinese=16'h18fc;
   12'hb53:chinese=16'h7d8c;
   12'hb54:chinese=16'h1948;
   12'hb55:chinese=16'h1870;
   12'hb56:chinese=16'h3c30;
   12'hb57:chinese=16'h3cdc;
   12'hb58:chinese=16'h3b06;
   12'hb59:chinese=16'h59fc;
   12'hb5a:chinese=16'h5984;
   12'hb5b:chinese=16'h1984;
   12'hb5c:chinese=16'h19fc;
   12'hb5d:chinese=16'h1984;
   12'hb5e:chinese=16'h1980;
   // 涟: complete SimHei glyph, centered inside 16x16
   12'hb60:chinese=16'h0020;
   12'hb61:chinese=16'h6420;
   12'hb62:chinese=16'h36fe;
   12'hb63:chinese=16'h0040;
   12'hb64:chinese=16'h0050;
   12'hb65:chinese=16'h4090;
   12'hb66:chinese=16'h2efe;
   12'hb67:chinese=16'h0610;
   12'hb68:chinese=16'h0610;
   12'hb69:chinese=16'h17fe;
   12'hb6a:chinese=16'h3610;
   12'hb6b:chinese=16'h2610;
   12'hb6c:chinese=16'h6f10;
   12'hb6d:chinese=16'h49fe;
   12'hb6e:chinese=16'h0002;
   // 漪: complete SimHei glyph, centered inside 16x16
   12'hb70:chinese=16'h0910;
   12'hb71:chinese=16'h6ffe;
   12'hb72:chinese=16'h3610;
   12'hb73:chinese=16'h0e38;
   12'hb74:chinese=16'h1ac4;
   12'hb75:chinese=16'h6200;
   12'hb76:chinese=16'h02fe;
   12'hb77:chinese=16'h06f4;
   12'hb78:chinese=16'h2e94;
   12'hb79:chinese=16'h2a94;
   12'hb7a:chinese=16'h2294;
   12'hb7b:chinese=16'h2264;
   12'hb7c:chinese=16'h4204;
   12'hb7d:chinese=16'h4e1c;
   12'hb7e:chinese=16'h0008;
   // 背: complete SimHei glyph, centered inside 16x16
   12'hb80:chinese=16'h0240;
   12'hb81:chinese=16'h0244;
   12'hb82:chinese=16'h7e78;
   12'hb83:chinese=16'h0240;
   12'hb84:chinese=16'h7e42;
   12'hb85:chinese=16'h423e;
   12'hb87:chinese=16'h1ff8;
   12'hb88:chinese=16'h1808;
   12'hb89:chinese=16'h1ff8;
   12'hb8a:chinese=16'h1808;
   12'hb8b:chinese=16'h1ff8;
   12'hb8c:chinese=16'h1808;
   12'hb8d:chinese=16'h1838;
   12'hb8e:chinese=16'h1820;
   // 景: complete SimHei glyph, centered inside 16x16
   12'hb90:chinese=16'h1ff8;
   12'hb91:chinese=16'h1008;
   12'hb92:chinese=16'h1ff8;
   12'hb93:chinese=16'h1008;
   12'hb94:chinese=16'h1ff8;
   12'hb95:chinese=16'h0100;
   12'hb96:chinese=16'h7ffe;
   12'hb98:chinese=16'h1ff8;
   12'hb99:chinese=16'h1808;
   12'hb9a:chinese=16'h1ff8;
   12'hb9b:chinese=16'h0080;
   12'hb9c:chinese=16'h1c98;
   12'hb9d:chinese=16'h3384;
   12'hb9e:chinese=16'h2300;
   // 重: complete SimHei glyph, centered inside 16x16
   12'hba1:chinese=16'h3ff8;
   12'hba2:chinese=16'h0180;
   12'hba3:chinese=16'h7ffe;
   12'hba4:chinese=16'h0180;
   12'hba5:chinese=16'h1ff8;
   12'hba6:chinese=16'h1188;
   12'hba7:chinese=16'h1ff8;
   12'hba8:chinese=16'h1188;
   12'hba9:chinese=16'h1ff8;
   12'hbaa:chinese=16'h0180;
   12'hbab:chinese=16'h3ffc;
   12'hbac:chinese=16'h0180;
   12'hbad:chinese=16'h7ffe;
   // 新: complete SimHei glyph, centered inside 16x16
   12'hbb0:chinese=16'h0806;
   12'hbb1:chinese=16'h0c78;
   12'hbb2:chinese=16'h7f60;
   12'hbb3:chinese=16'h2260;
   12'hbb4:chinese=16'h1260;
   12'hbb5:chinese=16'h7ffe;
   12'hbb6:chinese=16'h7fe4;
   12'hbb7:chinese=16'h0864;
   12'hbb8:chinese=16'h7fe4;
   12'hbb9:chinese=16'h0864;
   12'hbba:chinese=16'h3a44;
   12'hbbb:chinese=16'h6944;
   12'hbbc:chinese=16'h48c4;
   12'hbbd:chinese=16'h1884;
   12'hbbe:chinese=16'h1084;
   // 红: complete SimHei glyph, centered inside 16x16
   12'hbc1:chinese=16'h1800;
   12'hbc2:chinese=16'h11fe;
   12'hbc3:chinese=16'h2230;
   12'hbc4:chinese=16'h2630;
   12'hbc5:chinese=16'h7c30;
   12'hbc6:chinese=16'h0830;
   12'hbc7:chinese=16'h1830;
   12'hbc8:chinese=16'h3030;
   12'hbc9:chinese=16'h7e30;
   12'hbca:chinese=16'h0030;
   12'hbcb:chinese=16'h0230;
   12'hbcc:chinese=16'h7c30;
   12'hbcd:chinese=16'h61fe;
   // 黄: complete SimHei glyph, centered inside 16x16
   12'hbd0:chinese=16'h0620;
   12'hbd1:chinese=16'h3ffe;
   12'hbd2:chinese=16'h0620;
   12'hbd3:chinese=16'h0620;
   12'hbd4:chinese=16'h7ffe;
   12'hbd5:chinese=16'h0180;
   12'hbd6:chinese=16'h1ff8;
   12'hbd7:chinese=16'h1188;
   12'hbd8:chinese=16'h1ff8;
   12'hbd9:chinese=16'h1188;
   12'hbda:chinese=16'h1ff8;
   12'hbdb:chinese=16'h0420;
   12'hbdc:chinese=16'h0c18;
   12'hbdd:chinese=16'h300e;
   12'hbde:chinese=16'h2000;
   // 绿: complete SimHei glyph, centered inside 16x16
   12'hbe0:chinese=16'h1000;
   12'hbe1:chinese=16'h11fc;
   12'hbe2:chinese=16'h3004;
   12'hbe3:chinese=16'h25fc;
   12'hbe4:chinese=16'h6c04;
   12'hbe5:chinese=16'h780c;
   12'hbe6:chinese=16'h1bfe;
   12'hbe7:chinese=16'h1020;
   12'hbe8:chinese=16'h2126;
   12'hbe9:chinese=16'h7cf8;
   12'hbea:chinese=16'h00e8;
   12'hbeb:chinese=16'h05ac;
   12'hbec:chinese=16'h7b26;
   12'hbed:chinese=16'h0062;
   12'hbee:chinese=16'h0040;
   // 蓝: complete SimHei glyph, centered inside 16x16
   12'hbf1:chinese=16'h0460;
   12'hbf2:chinese=16'h7ffe;
   12'hbf3:chinese=16'h0460;
   12'hbf4:chinese=16'h0060;
   12'hbf5:chinese=16'h3660;
   12'hbf6:chinese=16'h367e;
   12'hbf7:chinese=16'h36c0;
   12'hbf8:chinese=16'h3690;
   12'hbf9:chinese=16'h3618;
   12'hbfb:chinese=16'h1ffc;
   12'hbfc:chinese=16'h124c;
   12'hbfd:chinese=16'h124c;
   12'hbfe:chinese=16'h7ffe;
   // 圆: complete SimHei glyph, centered inside 16x16
   12'hc01:chinese=16'h3ffc;
   12'hc02:chinese=16'h27e4;
   12'hc03:chinese=16'h2424;
   12'hc04:chinese=16'h27e4;
   12'hc05:chinese=16'h2004;
   12'hc06:chinese=16'h27e4;
   12'hc07:chinese=16'h2424;
   12'hc08:chinese=16'h25a4;
   12'hc09:chinese=16'h2524;
   12'hc0a:chinese=16'h2144;
   12'hc0b:chinese=16'h2e34;
   12'hc0c:chinese=16'h2814;
   12'hc0d:chinese=16'h3ffc;
   12'hc0e:chinese=16'h2004;
   // 三: complete SimHei glyph, centered inside 16x16
   12'hc12:chinese=16'h3ffc;
   12'hc16:chinese=16'h1ff8;
   12'hc17:chinese=16'h1ff8;
   12'hc1c:chinese=16'h7ffe;
   // 角: complete SimHei glyph, centered inside 16x16
   12'hc21:chinese=16'h0600;
   12'hc22:chinese=16'h0400;
   12'hc23:chinese=16'h0ff0;
   12'hc24:chinese=16'h1860;
   12'hc25:chinese=16'h7ffc;
   12'hc26:chinese=16'h1084;
   12'hc27:chinese=16'h1084;
   12'hc28:chinese=16'h1ffc;
   12'hc29:chinese=16'h1084;
   12'hc2a:chinese=16'h1084;
   12'hc2b:chinese=16'h1ffc;
   12'hc2c:chinese=16'h1084;
   12'hc2d:chinese=16'h2084;
   12'hc2e:chinese=16'h609c;
   // 矩: complete SimHei glyph, centered inside 16x16
   12'hc31:chinese=16'h1000;
   12'hc32:chinese=16'h30fe;
   12'hc33:chinese=16'h3e80;
   12'hc34:chinese=16'h3e80;
   12'hc35:chinese=16'h4880;
   12'hc36:chinese=16'h08fc;
   12'hc37:chinese=16'h0884;
   12'hc38:chinese=16'h7e84;
   12'hc39:chinese=16'h0884;
   12'hc3a:chinese=16'h18fc;
   12'hc3b:chinese=16'h1c80;
   12'hc3c:chinese=16'h1680;
   12'hc3d:chinese=16'h3380;
   12'hc3e:chinese=16'h60fe;
   // 确: complete SimHei glyph, centered inside 16x16
   12'hc40:chinese=16'h0040;
   12'hc41:chinese=16'h7ec0;
   12'hc42:chinese=16'h10b8;
   12'hc43:chinese=16'h1110;
   12'hc44:chinese=16'h10fe;
   12'hc45:chinese=16'h30b2;
   12'hc46:chinese=16'h3cb2;
   12'hc47:chinese=16'h64fe;
   12'hc48:chinese=16'h64b2;
   12'hc49:chinese=16'h24b2;
   12'hc4a:chinese=16'h24fe;
   12'hc4b:chinese=16'h3db2;
   12'hc4c:chinese=16'h2532;
   12'hc4d:chinese=16'h233e;
   12'hc4e:chinese=16'h0004;
   // 全: complete SimHei glyph, centered inside 16x16
   12'hc51:chinese=16'h0180;
   12'hc52:chinese=16'h0180;
   12'hc53:chinese=16'h02c0;
   12'hc54:chinese=16'h0660;
   12'hc55:chinese=16'h1c38;
   12'hc56:chinese=16'h300e;
   12'hc57:chinese=16'h6ff2;
   12'hc58:chinese=16'h0180;
   12'hc59:chinese=16'h0180;
   12'hc5a:chinese=16'h1ff8;
   12'hc5b:chinese=16'h0180;
   12'hc5c:chinese=16'h0180;
   12'hc5d:chinese=16'h0180;
   12'hc5e:chinese=16'h3ffc;
   // 局: complete SimHei glyph, centered inside 16x16
   12'hc61:chinese=16'h1ffc;
   12'hc62:chinese=16'h1004;
   12'hc63:chinese=16'h1004;
   12'hc64:chinese=16'h1ffc;
   12'hc65:chinese=16'h1000;
   12'hc66:chinese=16'h1000;
   12'hc67:chinese=16'h1ffe;
   12'hc68:chinese=16'h1002;
   12'hc69:chinese=16'h17e2;
   12'hc6a:chinese=16'h1622;
   12'hc6b:chinese=16'h3622;
   12'hc6c:chinese=16'h27e2;
   12'hc6d:chinese=16'h67e6;
   12'hc6e:chinese=16'h400c;
   // 变: complete SimHei glyph, centered inside 16x16
   12'hc70:chinese=16'h0100;
   12'hc71:chinese=16'h0180;
   12'hc72:chinese=16'h7ffe;
   12'hc73:chinese=16'h0240;
   12'hc74:chinese=16'h1258;
   12'hc75:chinese=16'h324c;
   12'hc76:chinese=16'h6246;
   12'hc77:chinese=16'h0240;
   12'hc78:chinese=16'h3ff8;
   12'hc79:chinese=16'h0430;
   12'hc7a:chinese=16'h0660;
   12'hc7b:chinese=16'h03c0;
   12'hc7c:chinese=16'h03c0;
   12'hc7d:chinese=16'h7c3e;
   12'hc7e:chinese=16'h2000;
   // 化: complete SimHei glyph, centered inside 16x16
   12'hc81:chinese=16'h08c0;
   12'hc82:chinese=16'h0cc0;
   12'hc83:chinese=16'h08c4;
   12'hc84:chinese=16'h18c4;
   12'hc85:chinese=16'h18cc;
   12'hc86:chinese=16'h38d8;
   12'hc87:chinese=16'h78e0;
   12'hc88:chinese=16'h18c0;
   12'hc89:chinese=16'h19c0;
   12'hc8a:chinese=16'h1fc0;
   12'hc8b:chinese=16'h18c0;
   12'hc8c:chinese=16'h18c2;
   12'hc8d:chinese=16'h18c2;
   12'hc8e:chinese=16'h187e;
   // 卡: complete SimHei glyph, centered inside 16x16
   12'hc90:chinese=16'h0100;
   12'hc91:chinese=16'h0100;
   12'hc92:chinese=16'h01fc;
   12'hc93:chinese=16'h0104;
   12'hc94:chinese=16'h0100;
   12'hc95:chinese=16'h0100;
   12'hc96:chinese=16'h7ffe;
   12'hc97:chinese=16'h0100;
   12'hc98:chinese=16'h0140;
   12'hc99:chinese=16'h0170;
   12'hc9a:chinese=16'h0118;
   12'hc9b:chinese=16'h0108;
   12'hc9c:chinese=16'h0100;
   12'hc9d:chinese=16'h0100;
   12'hc9e:chinese=16'h0100;
   // 通: complete SimHei glyph, centered inside 16x16
   12'hca1:chinese=16'h27fc;
   12'hca2:chinese=16'h2018;
   12'hca3:chinese=16'h30b0;
   12'hca4:chinese=16'h0060;
   12'hca5:chinese=16'h07fc;
   12'hca6:chinese=16'h7444;
   12'hca7:chinese=16'h77fc;
   12'hca8:chinese=16'h3444;
   12'hca9:chinese=16'h3444;
   12'hcaa:chinese=16'h37fc;
   12'hcab:chinese=16'h3444;
   12'hcac:chinese=16'h344c;
   12'hcad:chinese=16'h3800;
   12'hcae:chinese=16'h47fe;
   // 面: complete SimHei glyph, centered inside 16x16
   12'hcb1:chinese=16'h7ffe;
   12'hcb2:chinese=16'h0100;
   12'hcb3:chinese=16'h0300;
   12'hcb4:chinese=16'h3ffc;
   12'hcb5:chinese=16'h2644;
   12'hcb6:chinese=16'h2644;
   12'hcb7:chinese=16'h27c4;
   12'hcb8:chinese=16'h2644;
   12'hcb9:chinese=16'h27c4;
   12'hcba:chinese=16'h2644;
   12'hcbb:chinese=16'h2644;
   12'hcbc:chinese=16'h3ffc;
   12'hcbd:chinese=16'h2004;
   default:chinese=0;
  endcase
 end
 assign bits=code[7]?chinese:code==58?((row==4 || row==5 || row==10 || row==11)?16'h0300:16'd0):{2'b0,latin[4],latin[4],latin[3],latin[3],latin[2],latin[2],latin[1],latin[1],latin[0],latin[0],4'b0};
endmodule

// Clocked font consumes an EXISTING glyph register in the video pipeline.
// Bank 1 is a compact 16-glyph shape vocabulary; bank 0 is the full vocabulary.
module presentation_font16_sync #(parameter BANK=0)(input wire clk,
 input wire [7:0] code,input wire [3:0] row,output wire [15:0] bits);
 wire [4:0] latin;
 wire [7:0] latin_code=code==109?8'd77:code==115?8'd83:code;
 osd_font5x7 ascii_font(.code(latin_code),.row(row[3:1]),.bits(latin));
 reg [15:0] chinese_q,ascii_q;reg choose_chinese;
 always @(posedge clk)begin
  choose_chinese<=code[7];
  ascii_q<=code==58?((row==4 || row==5 || row==10 || row==11)?16'h0300:16'd0):
    {2'b0,latin[4],latin[4],latin[3],latin[3],latin[2],latin[2],latin[1],latin[1],latin[0],latin[0],4'b0};
 end
 generate if(BANK==1)begin:compact
  (* ram_style="block" *) reg [15:0] bitmap[0:255];
  reg [3:0] slot;
  always @*begin
   slot=0;
   case(code)
    8'd188:slot=4'd1;
    8'd189:slot=4'd2;
    8'd190:slot=4'd3;
    8'd191:slot=4'd4;
    8'd129:slot=4'd5;
    8'd154:slot=4'd6;
    8'd196:slot=4'd7;
    8'd180:slot=4'd8;
    8'd192:slot=4'd9;
    8'd144:slot=4'd10;
    8'd193:slot=4'd11;
    8'd194:slot=4'd12;
    8'd195:slot=4'd13;
    default:slot=0;
   endcase
  end
  integer i;
  initial begin
   for(i=0;i<256;i=i+1)bitmap[i]=0;
   bitmap[17]=16'h1800;
   bitmap[18]=16'h11fe;
   bitmap[19]=16'h2230;
   bitmap[20]=16'h2630;
   bitmap[21]=16'h7c30;
   bitmap[22]=16'h0830;
   bitmap[23]=16'h1830;
   bitmap[24]=16'h3030;
   bitmap[25]=16'h7e30;
   bitmap[26]=16'h0030;
   bitmap[27]=16'h0230;
   bitmap[28]=16'h7c30;
   bitmap[29]=16'h61fe;
   bitmap[32]=16'h0620;
   bitmap[33]=16'h3ffe;
   bitmap[34]=16'h0620;
   bitmap[35]=16'h0620;
   bitmap[36]=16'h7ffe;
   bitmap[37]=16'h0180;
   bitmap[38]=16'h1ff8;
   bitmap[39]=16'h1188;
   bitmap[40]=16'h1ff8;
   bitmap[41]=16'h1188;
   bitmap[42]=16'h1ff8;
   bitmap[43]=16'h0420;
   bitmap[44]=16'h0c18;
   bitmap[45]=16'h300e;
   bitmap[46]=16'h2000;
   bitmap[48]=16'h1000;
   bitmap[49]=16'h11fc;
   bitmap[50]=16'h3004;
   bitmap[51]=16'h25fc;
   bitmap[52]=16'h6c04;
   bitmap[53]=16'h780c;
   bitmap[54]=16'h1bfe;
   bitmap[55]=16'h1020;
   bitmap[56]=16'h2126;
   bitmap[57]=16'h7cf8;
   bitmap[58]=16'h00e8;
   bitmap[59]=16'h05ac;
   bitmap[60]=16'h7b26;
   bitmap[61]=16'h0062;
   bitmap[62]=16'h0040;
   bitmap[65]=16'h0460;
   bitmap[66]=16'h7ffe;
   bitmap[67]=16'h0460;
   bitmap[68]=16'h0060;
   bitmap[69]=16'h3660;
   bitmap[70]=16'h367e;
   bitmap[71]=16'h36c0;
   bitmap[72]=16'h3690;
   bitmap[73]=16'h3618;
   bitmap[75]=16'h1ffc;
   bitmap[76]=16'h124c;
   bitmap[77]=16'h124c;
   bitmap[78]=16'h7ffe;
   bitmap[81]=16'h0600;
   bitmap[82]=16'h0400;
   bitmap[83]=16'h0fe0;
   bitmap[84]=16'h1860;
   bitmap[85]=16'h3040;
   bitmap[86]=16'h7ff8;
   bitmap[87]=16'h1088;
   bitmap[88]=16'h1088;
   bitmap[89]=16'h1ff8;
   bitmap[90]=16'h1008;
   bitmap[91]=16'h1000;
   bitmap[92]=16'h1000;
   bitmap[93]=16'h1806;
   bitmap[94]=16'h1ffc;
   bitmap[97]=16'h0100;
   bitmap[98]=16'h0100;
   bitmap[99]=16'h0100;
   bitmap[100]=16'h3ff8;
   bitmap[101]=16'h0100;
   bitmap[102]=16'h0100;
   bitmap[103]=16'h7ffe;
   bitmap[104]=16'h0380;
   bitmap[105]=16'h0740;
   bitmap[106]=16'h0d60;
   bitmap[107]=16'h1930;
   bitmap[108]=16'h311c;
   bitmap[109]=16'h6106;
   bitmap[110]=16'h0100;
   bitmap[112]=16'h0040;
   bitmap[113]=16'h7ec0;
   bitmap[114]=16'h10b8;
   bitmap[115]=16'h1110;
   bitmap[116]=16'h10fe;
   bitmap[117]=16'h30b2;
   bitmap[118]=16'h3cb2;
   bitmap[119]=16'h64fe;
   bitmap[120]=16'h64b2;
   bitmap[121]=16'h24b2;
   bitmap[122]=16'h24fe;
   bitmap[123]=16'h3db2;
   bitmap[124]=16'h2532;
   bitmap[125]=16'h233e;
   bitmap[126]=16'h0004;
   bitmap[129]=16'h0100;
   bitmap[130]=16'h0180;
   bitmap[131]=16'h3ffc;
   bitmap[132]=16'h2004;
   bitmap[133]=16'h2004;
   bitmap[134]=16'h1ff8;
   bitmap[135]=16'h0080;
   bitmap[136]=16'h0080;
   bitmap[137]=16'h0880;
   bitmap[138]=16'h18f8;
   bitmap[139]=16'h1880;
   bitmap[140]=16'h3c80;
   bitmap[141]=16'h2780;
   bitmap[142]=16'h61fe;
   bitmap[145]=16'h3ffc;
   bitmap[146]=16'h27e4;
   bitmap[147]=16'h2424;
   bitmap[148]=16'h27e4;
   bitmap[149]=16'h2004;
   bitmap[150]=16'h27e4;
   bitmap[151]=16'h2424;
   bitmap[152]=16'h25a4;
   bitmap[153]=16'h2524;
   bitmap[154]=16'h2144;
   bitmap[155]=16'h2e34;
   bitmap[156]=16'h2814;
   bitmap[157]=16'h3ffc;
   bitmap[158]=16'h2004;
   bitmap[161]=16'h7f8c;
   bitmap[162]=16'h1218;
   bitmap[163]=16'h1230;
   bitmap[164]=16'h1260;
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
   bitmap[1208]=16'h2644;
   bitmap[1209]=16'h27c4;
   bitmap[1210]=16'h2644;
   bitmap[1211]=16'h2644;
   bitmap[1212]=16'h3ffc;
   bitmap[1213]=16'h2004;
  end
  always @(posedge clk)chinese_q<=bitmap[{code[6:0],row}];
 end endgenerate
 assign bits=choose_chinese?chinese_q:ascii_q;
endmodule
