whywhywhyt/fpga-sram-demo/engineering/candidates/sc520_cal_final_2026-11-01/candidate/sc520_shapes/user_source/hdl_source/hdmi_camera_mixer.v

module hdmi_camera_mixer #(
    parameter H_OFFSET = 0,
    parameter V_OFFSET = 0,
    parameter IMG_WIDTH = 1600,
    parameter IMG_HEIGHT = 900,
    parameter integer DEBUG_MODE = 0,
    parameter integer INPUT_READ_LATENCY = 0
)(
    input wire        I_clk,
    input wire        I_rst_n,

    input wire        I_video_vsync,
    input wire        I_video_hsync,
    input wire        I_video_de,
    input wire        I_video_user,
    input wire        I_video_last,

    input wire[23:0]  I_debug_status,

    output wire       O_video_rd_en,
    input wire[23:0]  I_video_rd_data,

    output reg        O_hdmi_vsync,
    output reg        O_hdmi_hsync,
    output reg        O_hdmi_de,
    output reg[23:0]  O_hdmi_data
);

    reg        S_video_vsync_1d;
    reg        S_video_vsync_2d;
    reg        S_video_hsync_1d;
    reg        S_video_hsync_2d;
    reg        S_video_de_1d;
    reg        S_video_de_2d;
    reg [23:0] S_video_data_1d;
    reg [23:0] S_video_data_2d;
    reg        S_window_active_1d;
    reg        S_window_active_2d;
    reg [11:0] S_x;
    reg [11:0] S_y;

    wire S_window_active;
    // user accompanies the first active pixel. At a new frame the old y
    // register still holds IMG_HEIGHT; use the new coordinates immediately.
    wire [11:0] S_current_x = I_video_user ? 12'd0 : S_x;
    wire [11:0] S_current_y = I_video_user ? 12'd0 : S_y;
    assign S_window_active = I_video_de &&
                             (S_current_x >= H_OFFSET) &&
                             (S_current_x < (H_OFFSET + IMG_WIDTH)) &&
                             (S_current_y >= V_OFFSET) &&
                             (S_current_y < (V_OFFSET + IMG_HEIGHT));

    // Read exactly IMG_WIDTH pixels on each of IMG_HEIGHT lines.  The HDMI
    // active area may be larger than the stored frame, in which case remaining
    // pixels are emitted as black borders without consuming DDR data.
    assign O_video_rd_en = S_window_active;

    always @(posedge I_clk or negedge I_rst_n) begin
        if(!I_rst_n) begin
            S_x <= 12'd0;
            S_y <= 12'd0;
        end
        else begin
            if(I_video_user)
                S_y <= 12'd0;
            else if(I_video_de && I_video_last)
                S_y <= S_y + 12'd1;

            if(!I_video_de || I_video_last)
                S_x <= 12'd0;
            else
                S_x <= S_current_x + 12'd1;
        end
    end

    always @(posedge I_clk or negedge I_rst_n) begin
        if(!I_rst_n) begin
            S_video_vsync_1d <= 1'b0;
            S_video_vsync_2d <= 1'b0;
            S_video_hsync_1d <= 1'b0;
            S_video_hsync_2d <= 1'b0;
            S_video_de_1d    <= 1'b0;
            S_video_de_2d    <= 1'b0;
            S_window_active_1d <= 1'b0;
            S_window_active_2d <= 1'b0;
            O_hdmi_vsync     <= 1'b0;
            O_hdmi_hsync     <= 1'b0;
            O_hdmi_de        <= 1'b0;
            O_hdmi_data      <= 24'd0;
        end
        else begin
            S_video_vsync_1d <= I_video_vsync;
            S_video_vsync_2d <= S_video_vsync_1d;
            O_hdmi_vsync     <= S_video_vsync_2d;

            S_video_hsync_1d <= I_video_hsync;
            S_video_hsync_2d <= S_video_hsync_1d;
            O_hdmi_hsync     <= S_video_hsync_2d;

            S_video_de_1d    <= I_video_de;
            S_video_de_2d    <= S_video_de_1d;
            S_window_active_1d <= S_window_active;
            S_window_active_2d <= S_window_active_1d;
            O_hdmi_de        <= S_video_de_2d;
            S_video_data_1d  <= I_video_rd_data;
            S_video_data_2d  <= S_video_data_1d;

            if(DEBUG_MODE == 1) begin
                if(S_video_de_2d) begin
                    if(S_x < 12'd128)
                        O_hdmi_data <= 24'hff0000;
                    else if(S_x < 12'd256)
                        O_hdmi_data <= 24'h00ff00;
                    else if(S_x < 12'd384)
                        O_hdmi_data <= 24'h0000ff;
                    else if(S_x < 12'd512)
                        O_hdmi_data <= 24'hffff00;
                    else if(S_x < 12'd640)
                        O_hdmi_data <= 24'h00ffff;
                    else if(S_x < 12'd768)
                        O_hdmi_data <= 24'hff00ff;
                    else if(S_x < 12'd896)
                        O_hdmi_data <= 24'hffffff;
                    else
                        O_hdmi_data <= 24'h202020;
                end
                else begin
                    O_hdmi_data <= 24'd0;
                end
            end
            else if(DEBUG_MODE == 2) begin
                if(S_video_de_2d) begin
                    case (I_debug_status)
                        4'b0000: O_hdmi_data <= 24'h000000;
                        4'b0001: O_hdmi_data <= 24'hff0000;
                        4'b0011: O_hdmi_data <= 24'hffff00;
                        4'b0111: O_hdmi_data <= 24'h00ff00;
                        4'b1111: O_hdmi_data <= I_video_rd_data;
                        default: O_hdmi_data <= 24'h0000ff;
                    endcase
                end
                else begin
                    O_hdmi_data <= 24'd0;
                end
            end
            else if(DEBUG_MODE == 3) begin
                if(S_video_de_2d) begin
                    if(S_x < 12'd256)
                        O_hdmi_data <= I_debug_status[0] ? 24'hff8000 : 24'h201000;
                    else if(S_x < 12'd512)
                        O_hdmi_data <= I_debug_status[1] ? 24'hffff00 : 24'h202000;
                    else if(S_x < 12'd768)
                        O_hdmi_data <= I_debug_status[2] ? 24'hff0000 : 24'h200000;
                    else
                        O_hdmi_data <= I_debug_status[3] ? 24'h00ffff : 24'h002020;
                end
                else begin
                    O_hdmi_data <= 24'd0;
                end
            end
            else if(DEBUG_MODE == 4) begin
                // Full-screen MIPI receive diagnostic.  The status is
                // generated and synchronized in design_top_wrapper.
                if(S_video_de_2d) begin
                    case (I_debug_status)
                        4'd0: O_hdmi_data <= 24'h000080; // blue: sensor config incomplete
                        4'd1: O_hdmi_data <= 24'h000000; // black: no MIPI HS traffic
                        4'd2: O_hdmi_data <= 24'h00ffff; // cyan: HS present, no complete frame
                        4'd3: O_hdmi_data <= 24'hff0000; // red: D-PHY lane error
                        4'd4: O_hdmi_data <= 24'hff00ff; // magenta: RAW10 line length error
                        4'd5: O_hdmi_data <= 24'hffff00; // yellow: not 720 lines per frame
                        4'd6: O_hdmi_data <= 24'h00ff00; // green: MIPI frame structure passed
                        4'd7: O_hdmi_data <= 24'hff8000; // orange: sensor I2C transaction error
                        default: O_hdmi_data <= 24'hffffff;
                    endcase
                end
                else begin
                    O_hdmi_data <= 24'd0;
                end
            end
            else if(DEBUG_MODE == 5) begin
                if(!S_video_de_2d) O_hdmi_data <= 0;
                else if(S_y < 120) begin
                    if((S_x % 160) < 4 || (S_y % 40) < 4) O_hdmi_data <= 24'h101010;
                    else if(S_y < 80)
                        O_hdmi_data <= I_debug_status[(S_x / 160) + ((S_y >= 40) ? 8 : 0)] ? 24'h00ff00 : 24'h800000;
                    else
                        O_hdmi_data <= I_debug_status[16 + (S_x / 160)] ? 24'hff0000 : 24'h00ff00;
                end else if(S_y < 200) begin
                    case(S_x / 160)
                        0: O_hdmi_data <= 24'hff0000;
                        1: O_hdmi_data <= 24'h00ff00;
                        2: O_hdmi_data <= 24'h0000ff;
                        3: O_hdmi_data <= 24'hffff00;
                        4: O_hdmi_data <= 24'h00ffff;
                        5: O_hdmi_data <= 24'hff00ff;
                        6: O_hdmi_data <= 24'hffffff;
                        default: O_hdmi_data <= 24'h202020;
                    endcase
                end else O_hdmi_data <= S_window_active_2d ? S_video_data_2d : 24'd0;
            end
            else begin
                // Actual video_out supplies pixels two clocks after read.
                // The timing pipeline already accounts for those clocks;
                // delaying this pixel again would shift the image two pixels.
                O_hdmi_data <= S_window_active_2d ?
                    (INPUT_READ_LATENCY==2?I_video_rd_data:S_video_data_2d) : 24'd0;
            end
        end
    end

endmodule
